ottomated/e507/README.md

- [Part choices & planning](./docs/Parts.md)

- Datasheets, symbols, footprints, 3d models, and spice models are in the respective folders in `./parts`

## Schematics

### Power
Power

### MCU
MCU

### Audio
Audio

### Root
Power

## PCB

PCB

### Rendered
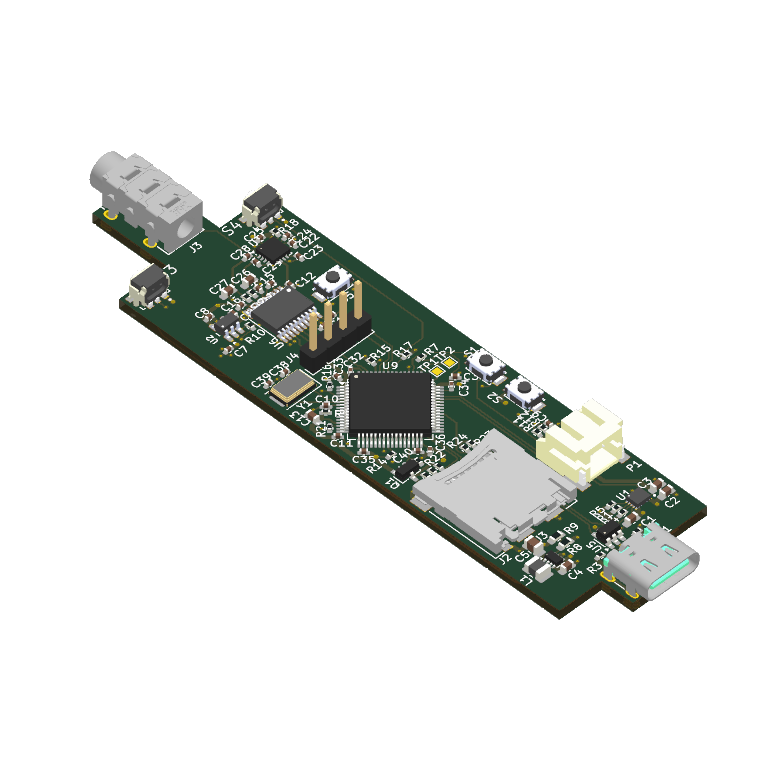
[picture p1: images/pcb.png]
Rendered
