ottomated/e507/docs/knob1.png

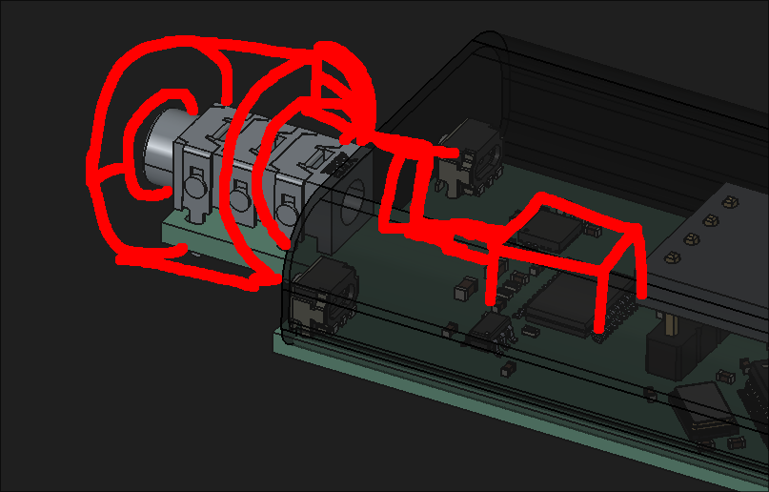
docs/knob1.png
