ottomated/e507/3d/case.FCStd

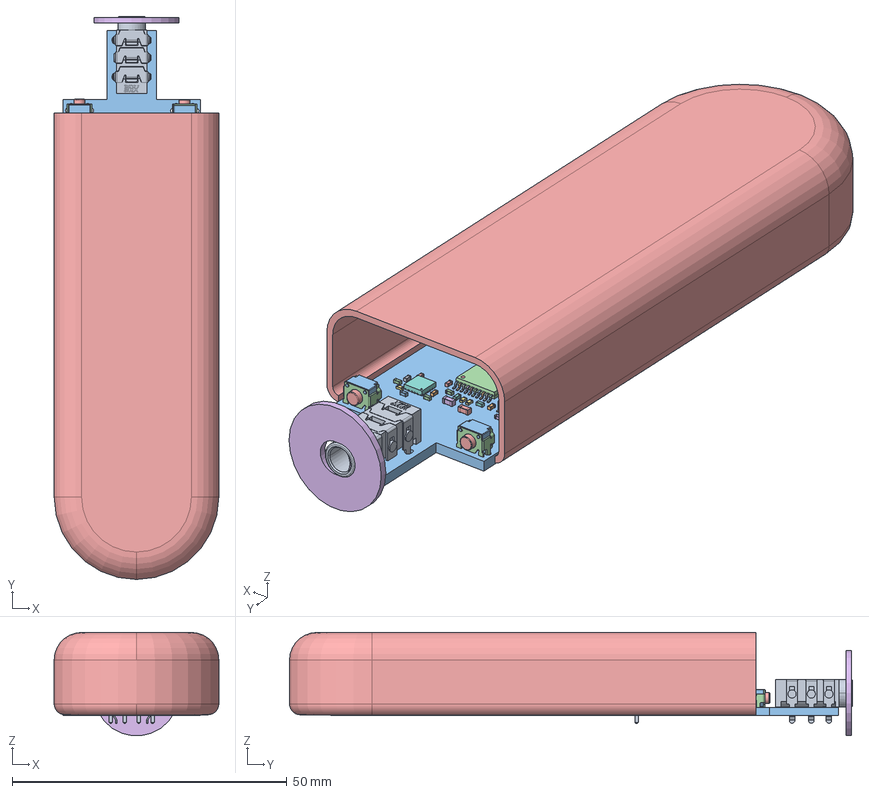
[picture p3: CAD file, 2026-11-06]
3d/case.FCStd
30.0 x 102.5 x 18.8 mm
R_0402_1005Metric
DM3CS-SF
C_0402_1005Metric
C_0402_1005Metric002
C_0402_1005Metric004
C_0603_1608Metric
S2B-PH-SM4-TB(LF)(SN)
S2B-PH-SM4-TB(LF)(SN)001
S2B-PH-SM4-TB(LF)(SN)002
S2B-PH-SM4-TB(LF)(SN)003
S2B-PH-SM4-TB(LF)(SN)004
TS-1088-AR02016
TS-1088-AR02017
TS-1088-AR02018
TS-1088-AR02019
C_0402_1005Metric006
PJ-3135-X
DBV5
DBV001
DBV002
DBV003
DBV004
DBV005
DBV006
C_0402_1005Metric008
L_1008_2520Metric
R_0402_1005Metric002
C_0402_1005Metric010
R_0402_1005Metric004
TS-1088-AR02022
TS-1088-AR02023
TS-1088-AR02024
TS-1088-AR02025
C_0603_1608Metric002
P021301_Shrinkwrap_1
P021301_Shrinkwrap_001
P021301_Shrinkwrap_002
C_0402_1005Metric012
R_0402_1005Metric006
C_0402_1005Metric014
R_0402_1005Metric008
LQFP-64_10x10mm_P0.5mm
TPS2116DRLR
TPS2116DRLR001
TPS2116DRLR002
TPS2116DRLR003
TPS2116DRLR004
TPS2116DRLR005
TPS2116DRLR006
TPS2116DRLR007
TPS2116DRLR008
TPS2116DRLR009
R_0402_1005Metric010
C_0402_1005Metric016
C_0402_1005Metric018
R_0402_1005Metric012
PinHeader_1x04_P254mm_Vertical
R_0402_1005Metric014
R_0402_1005Metric016
SOT-23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
