ottomated/e507/parts/amp/TPA6132A2RTER.step

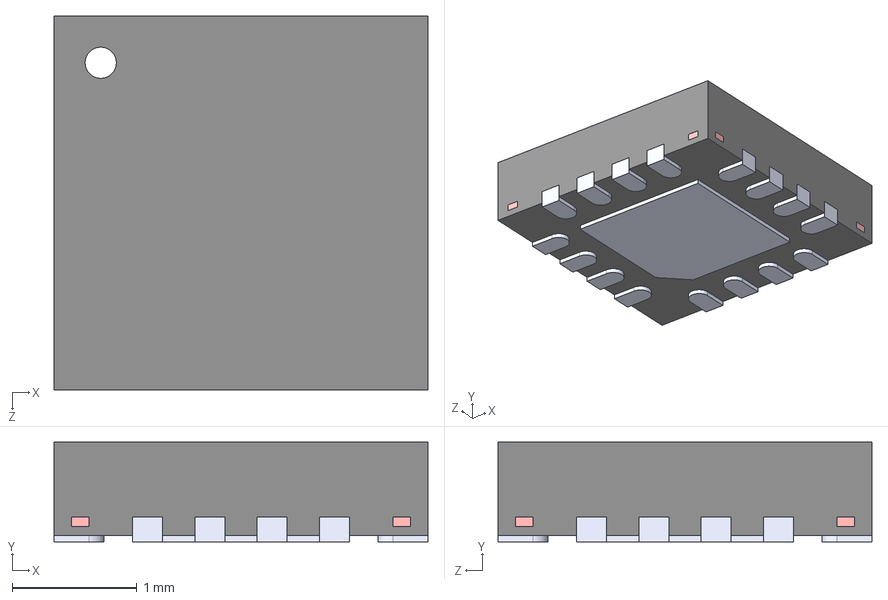
[picture p4: CAD file, 2026-10-21]
parts/amp/TPA6132A2RTER.step
3.00 x 0.8 x 3.00 mm
