ottomated/e507/parts/audio-jack/PJ-3135-B.stp

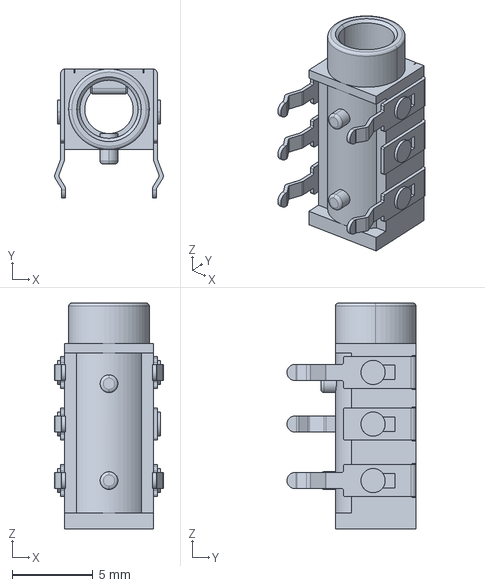
[picture p5: CAD file, 2026-11-05]
parts/audio-jack/PJ-3135-B.stp
6.74 x 8.00 x 14.0 mm
