ottomated/e507/(list of files, drawings)

Other design files:
parts/amp/spice/TPA6132A2.DSN
parts/amp/spice/TPA6132A2.OLB
parts/amp/spice/TPA6132A2.opj
parts/buck-boost/spice/GENERIC_BLOCKS.OLB
parts/buck-boost/spice/TPS631000.OLB
parts/buck-boost/spice/TPS631000_ENCRYPTED.DSN
parts/buck-boost/spice/TPS631000_Encrypted.opj
parts/buck-boost/spice/TPS631000_SYMBOL.OLB
parts/ldo/spice/TPS73601_TRANS.opj
