ottomated/e507/e507.kicad_pcb

## KiCad design e507.kicad_pcb (2026-11-12)

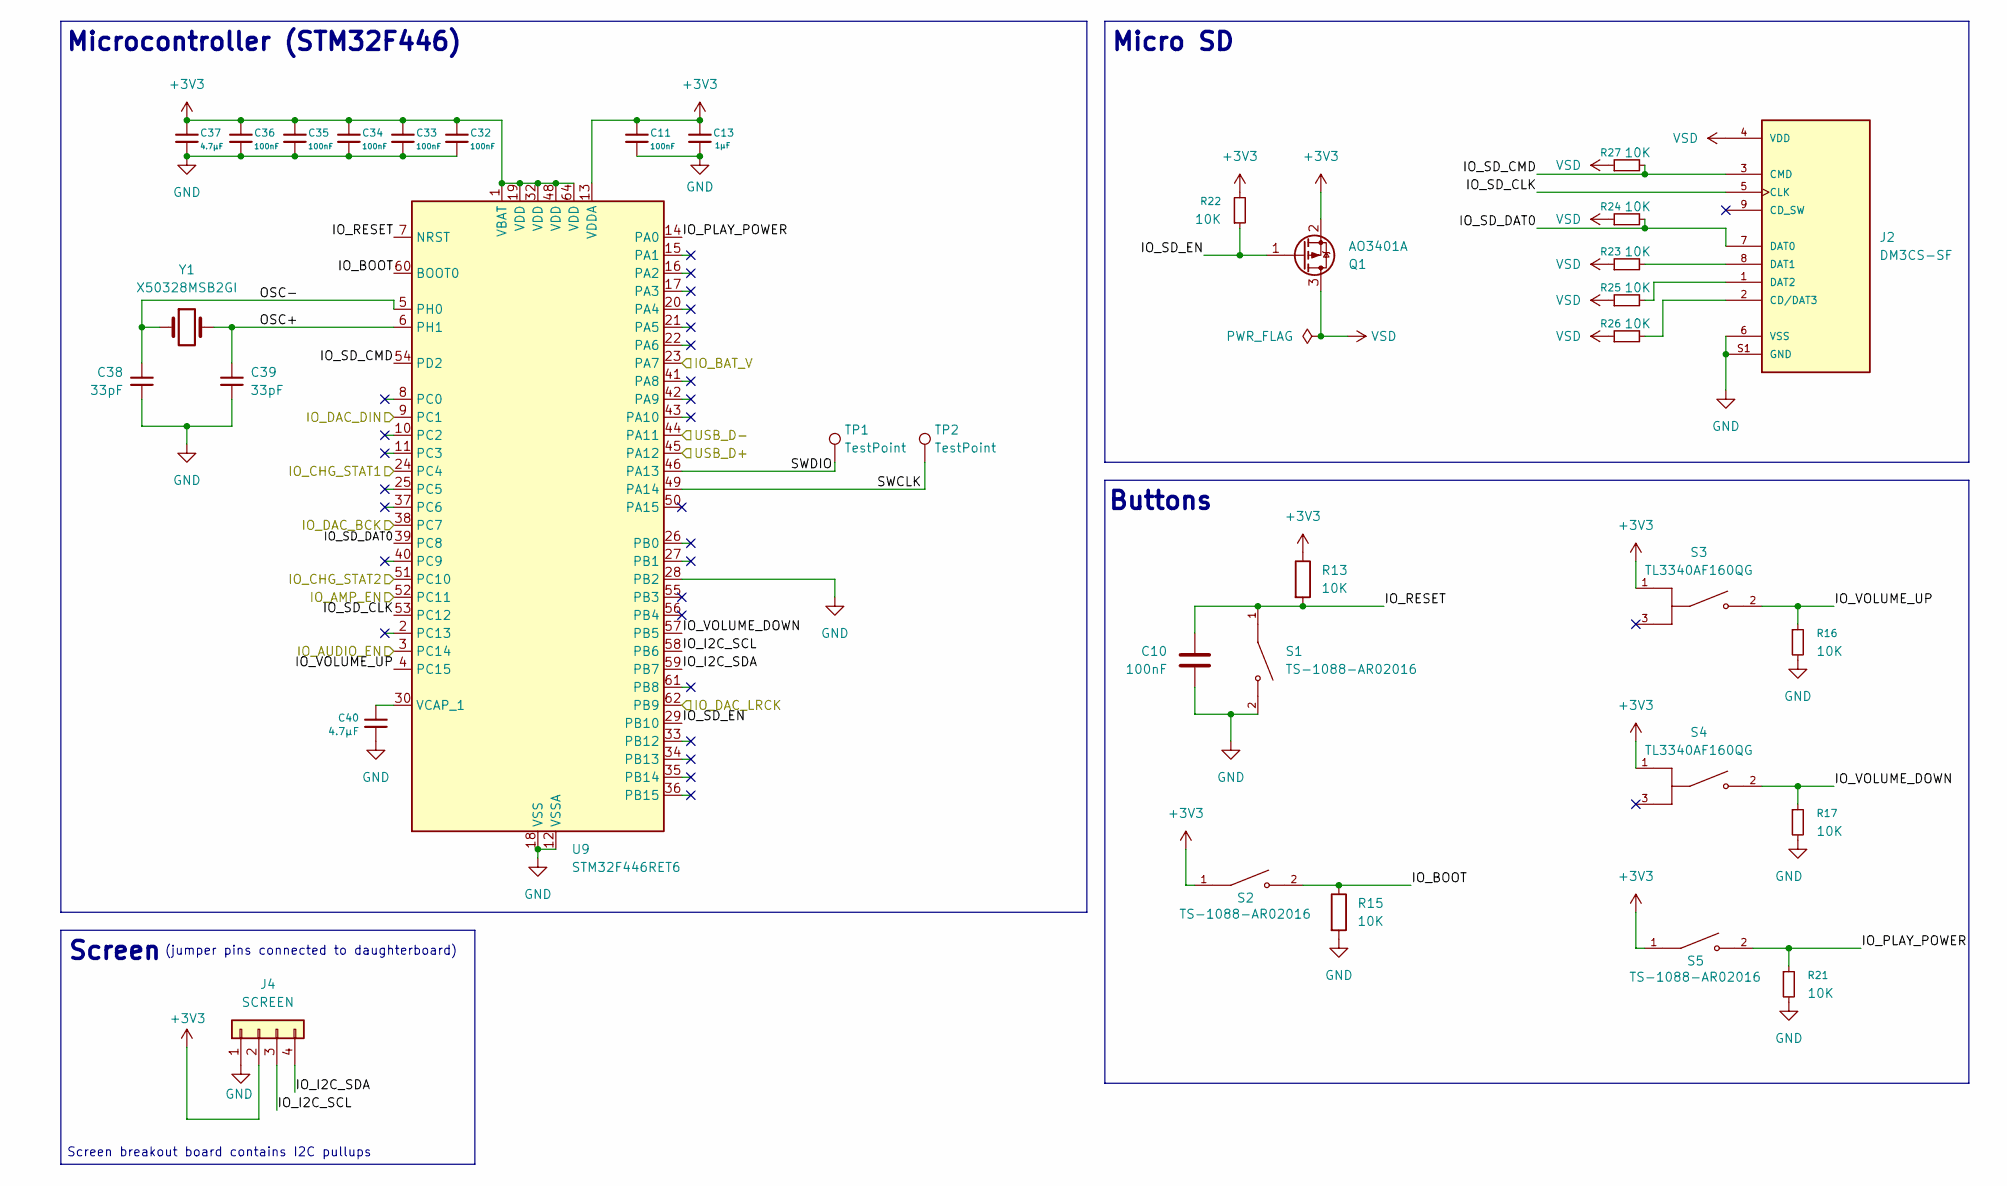
[picture p6: schematic mcu.kicad_sch]

Parts:
C10, C11, C32, C33, C34, C35, C36: 100nF; C_0402_1005Metric; Part # CL05B104KO5NNNC; LCSC Part # C1525
C13: 1µF; C_0603_1608Metric; Part # CL10A105KB8NNNC; LCSC Part # C15849
C37, C40: 4.7µF; C_0402_1005Metric; Part # CL05A475MP5NRNC; LCSC Part # C23733
C38, C39: 33pF; C_0402_1005Metric; Part # 0402CG330J500NT; LCSC Part # C1562
J2: DM3CS-SF; HRS_DM3CS-SF; PARTREV n/a; LCSC Part # C202111
J4: SCREEN; PinHeader_1x04_P2.54mm_Vertical; Part # 2.54-1*4; LCSC Part # C5116483
Q1: AO3401A; SOT-23; Part # AO3401A; LCSC Part # C15127
R13, R15, R16, R17, R21, R22, R23, R24, R25, R26, R27: 10K; R_0402_1005Metric; Part # 0402WGF1002TCE; LCSC Part # C25744
S1, S2, S5: TS-1088-AR02016; SW_TS-1088-AR02016; PARTREV N/A; LCSC Part # C720477
S3, S4: TL3340AF160QG; SW_TL3340AF160QG; Part # TL3340AF160QG; LCSC Part # C2886925
TP1, TP2: TestPoint; TestPoint_Pad_1.0x1.0mm
U9: STM32F446RET6; LQFP-64_10x10mm_P0.5mm; Part # STM32F446RET6; LCSC Part # C69336
Y1: X50328MSB2GI; Crystal_SMD_5032-2Pin_5.0x3.2mm; Part # X50328MSB2GI; LCSC Part # C115962

Connections:
+3V3: C11.1, C13.2, C32.1, C33.1, C34.1, C35.1, C36.1, C37.1, J4.2, Q1.2 (S), R13.1, R22.2, S2.1, S3.1, S4.1, S5.1, U9.1 (VBAT), U9.13 (VDDA), U9.19 (VDD), U9.32 (VDD), U9.48 (VDD), U9.64 (VDD); also elsewhere on the board
/Audio/IO_AMP_EN: U9.52 (PC11); also elsewhere on the board
/Audio/IO_DAC_BCK: U9.38 (PC7); also elsewhere on the board
/Audio/IO_DAC_DIN: U9.9 (PC1); also elsewhere on the board
/Audio/IO_DAC_LRCK: U9.62 (PB9); also elsewhere on the board
/MCU/IO_AUDIO_EN: U9.3 (PC14); also elsewhere on the board
/MCU/IO_BAT_V: U9.23 (PA7); also elsewhere on the board
/MCU/IO_BOOT: R15.1, S2.2, U9.60 (BOOT0)
/MCU/IO_CHG_STAT1: U9.24 (PC4); also elsewhere on the board
/MCU/IO_CHG_STAT2: U9.51 (PC10); also elsewhere on the board
/MCU/IO_I2C_SCL: J4.3, U9.58 (PB6)
/MCU/IO_I2C_SDA: J4.4, U9.59 (PB7)
/MCU/IO_PLAY_POWER: R21.1, S5.2, U9.14 (PA0)
/MCU/IO_RESET: C10.1, R13.2, S1.1, U9.7 (NRST)
/MCU/IO_SD_CLK: J2.5 (CLK), U9.53 (PC12)
/MCU/IO_SD_CMD: J2.3 (CMD), R27.2, U9.54 (PD2)
/MCU/IO_SD_DAT0: J2.7 (DAT0), R24.2, U9.39 (PC8)
/MCU/IO_SD_EN: Q1.1 (G), R22.1, U9.29 (PB10)
/MCU/IO_VOLUME_DOWN: R17.1, S4.2, U9.57 (PB5)
/MCU/IO_VOLUME_UP: R16.1, S3.2, U9.4 (PC15)
/MCU/OSC+: C39.1, U9.6 (PH1), Y1.2
/MCU/OSC-: C38.1, U9.5 (PH0), Y1.1
/MCU/SWCLK: TP2.1 (1_1), U9.49 (PA14)
/MCU/SWDIO: TP1.1 (1_1), U9.46 (PA13)
/MCU/USB_D+: U9.45 (PA12); also elsewhere on the board
/MCU/USB_D-: U9.44 (PA11); also elsewhere on the board
GND: C10.2, C11.2, C13.1, C32.2, C33.2, C34.2, C35.2, C36.2, C37.2, C38.2, C39.2, C40.2, J2.6 (VSS), J2.S1 (GND), J2.S2 (GND), J2.S3 (GND), J2.S5 (GND), J4.1, R15.2, R16.2, R17.2, R21.2, S1.2, U9.12 (VSSA), U9.18 (VSS), U9.28 (PB2), U9.31 (VSS), U9.47 (VSS), U9.63 (VSS); also elsewhere on the board
unnamed: J2.2 (CD/DAT3), R26.2
unnamed: J2.8 (DAT1), R23.2
unnamed: J2.1 (DAT2), R25.2
unnamed: C40.1, U9.30 (VCAP_1)
VSD: J2.4 (VDD), Q1.3 (D), R23.1, R24.1, R25.1, R26.1, R27.1

Notes on the sheet:
(jumper pins connected to daughterboard)
Micro SD
Buttons
Screen breakout board contains I2C pullups
Microcontroller (STM32F446)
Screen

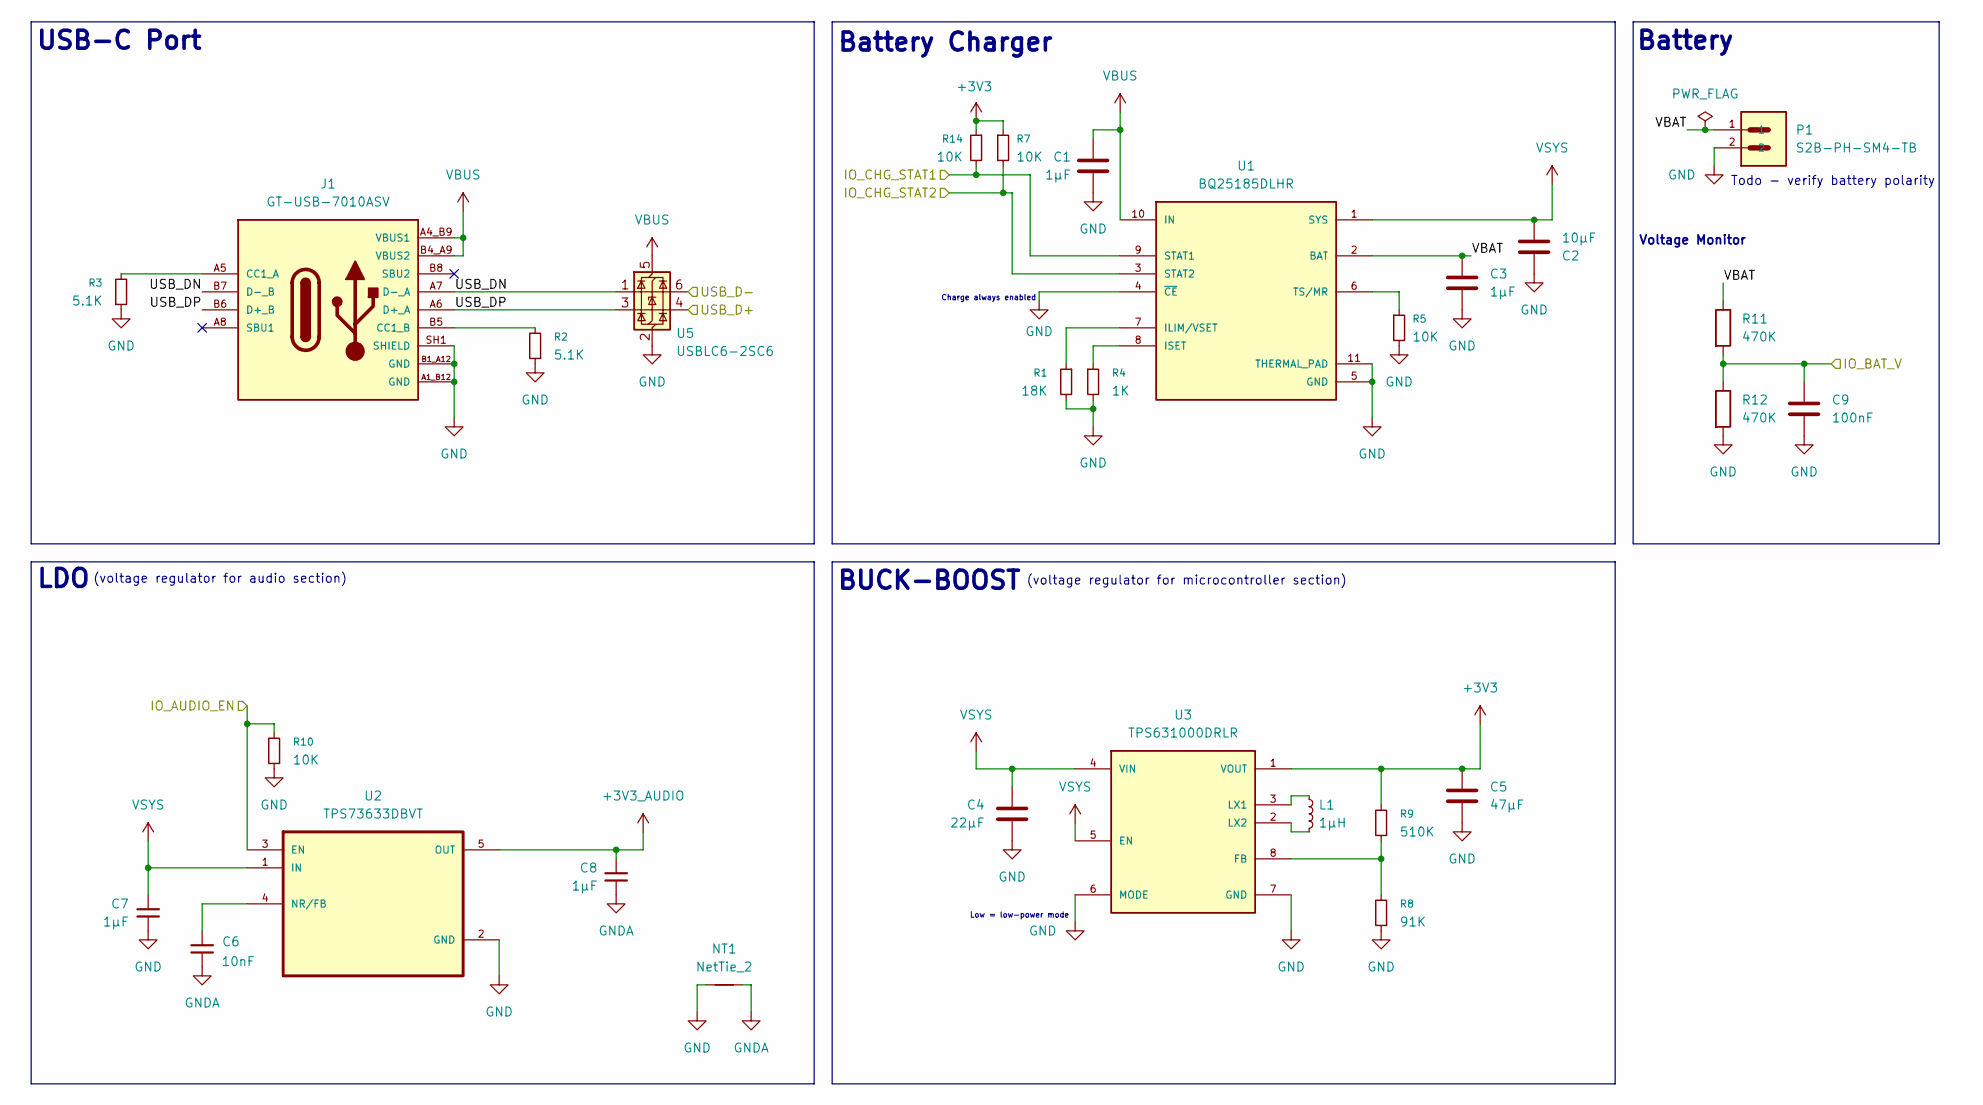
[picture p7: schematic power.kicad_sch]

Parts:
C1, C3: 1µF; C_0603_1608Metric; Part # CL10A105KB8NNNC; LCSC Part # C15849
C2: 10µF; C_0603_1608Metric; Part # CL10A106MA8NRNC; LCSC Part # C96446
C4: 22µF; C_0603_1608Metric; Part # CL10A226MQ8NRNC; LCSC Part # C59461
C5: 47µF; C_0805_2012Metric; Part # CL21A476MQYNNNE; LCSC Part # C16780
C6: 10nF; C_0402_1005Metric; Part # CL05B103KB5NNNC; LCSC Part # C15195
C7, C8: 1µF; C_0402_1005Metric; Part # CL05A105KA5NQNC; LCSC Part # C52923
C9: 100nF; C_0402_1005Metric; Part # CL05B104KO5NNNC; LCSC Part # C1525
J1: GT-USB-7010ASV; AMPHENOL_12402012E212A; PARTREV 4; LCSC Part # C2988369
L1: 1μH; L_1008_2520Metric; Part # DFE252012P-1R0M=P2; LCSC Part # C882955
NT1: NetTie_2; NetTie-2_SMD_Pad0.5mm
P1: S2B-PH-SM4-TB; JST_S2B-PH-SM4-TB; Part # XY-S2B-PH-SM4-TB; LCSC Part # C54582899
R1: 18K; R_0402_1005Metric; Part # 0402WGF1802TCE; LCSC Part # C25762
R2, R3: 5.1K; R_0402_1005Metric; Part # 0402WGF5101TCE; LCSC Part # C25905
R4: 1K; R_0402_1005Metric; Part # 0402WGF1001TCE; LCSC Part # C11702
R5, R7, R10, R14: 10K; R_0402_1005Metric; Part # 0402WGF1002TCE; LCSC Part # C25744
R8: 91K; R_0603_1608Metric; Part # 0603WAF9102T5E; LCSC Part # C23265
R9: 510K; R_0603_1608Metric; Part # 0603WAF5103T5E; LCSC Part # C23192
R11: 470K; R_0402_1005Metric; LCSC Part # C25790
R12: 470K; R_0402_1005Metric; Part # 0603WAF4703T5E; LCSC Part # C25790
U1: BQ25185DLHR; IC_BQ25185DLHR; PARTREV OCTOBER 2023; LCSC Part # C19725033
U2: TPS73633DBVT; SOT95P280X145-5N; Part # TPS73633DBVT; LCSC Part # C2864221
U3: TPS631000DRLR; SOT-583-8; PARTREV B; LCSC Part # C5219190
U5: USBLC6-2SC6; SOT-23-6; Part # ST USBLC6-2SC6; LCSC Part # C7519

Connections:
+3V3: C5.2, R7.1, R9.2, R14.1, U3.1 (VOUT); also elsewhere on the board
+3V3_AUDIO: C8.1, U2.5 (OUT); also elsewhere on the board
/MCU/IO_AUDIO_EN: R10.2, U2.3 (EN); also elsewhere on the board
/MCU/IO_BAT_V: C9.1, R11.2, R12.1; also elsewhere on the board
/MCU/IO_CHG_STAT1: R14.2, U1.9 (STAT1); also elsewhere on the board
/MCU/IO_CHG_STAT2: R7.2, U1.3 (STAT2); also elsewhere on the board
/MCU/USB_D+: U5.4 (I/O2); also elsewhere on the board
/MCU/USB_D-: U5.6 (I/O1); also elsewhere on the board
/Power/USB_DN: J1.A7 (D-_A), J1.B7 (D-_B), U5.1 (I/O1)
/Power/USB_DP: J1.A6 (D+_A), J1.B6 (D+_B), U5.3 (I/O2)
/Power/VBAT: C3.2, P1.1, R11.1, U1.2 (BAT)
GND: C1.1, C2.2, C3.1, C4.1, C5.1, C7.1, C9.2, J1.A1_B12 (GND), J1.B1_A12 (GND), J1.SH1 (SHIELD), J1.SH2 (SHIELD), J1.SH3 (SHIELD), J1.SH4 (SHIELD), NT1.1, P1.2, R1.2, R2.1, R3.1, R4.2, R5.2, R8.1, R10.1, R12.2, U1.4 (~CE), U1.5 (GND), U1.11 (THERMAL_PAD), U1.12, U1.13, U2.2 (GND), U3.6 (MODE), U3.7 (GND), U5.2 (GND); also elsewhere on the board
GNDA: C6.1, C8.2, NT1.2; also elsewhere on the board
unnamed: J1.A5 (CC1_A), R3.2
unnamed: J1.B5 (CC1_B), R2.2
unnamed: R1.1, U1.7 (ILIM/VSET)
unnamed: R4.1, U1.8 (ISET)
unnamed: R5.1, U1.6 (TS/MR)
unnamed: C6.2, U2.4 (NR/FB)
unnamed: R8.2, R9.1, U3.8 (FB)
unnamed: L1.1, U3.3 (LX1)
unnamed: L1.2, U3.2 (LX2)
VBUS: C1.2, J1.A4_B9 (VBUS1), J1.B4_A9 (VBUS), U1.10 (IN), U5.5 (VBUS)
VSYS: C2.1, C4.2, C7.2, U1.1 (SYS), U2.1 (IN), U3.4 (VIN), U3.5 (EN)

Notes on the sheet:
Charge always enabled
Battery Charger
(voltage regulator for microcontroller section)
Low = low-power mode
USB-C Port
Todo - verify battery polarity
(voltage regulator for audio section)
Battery
Voltage Monitor
LDO
BUCK-BOOST

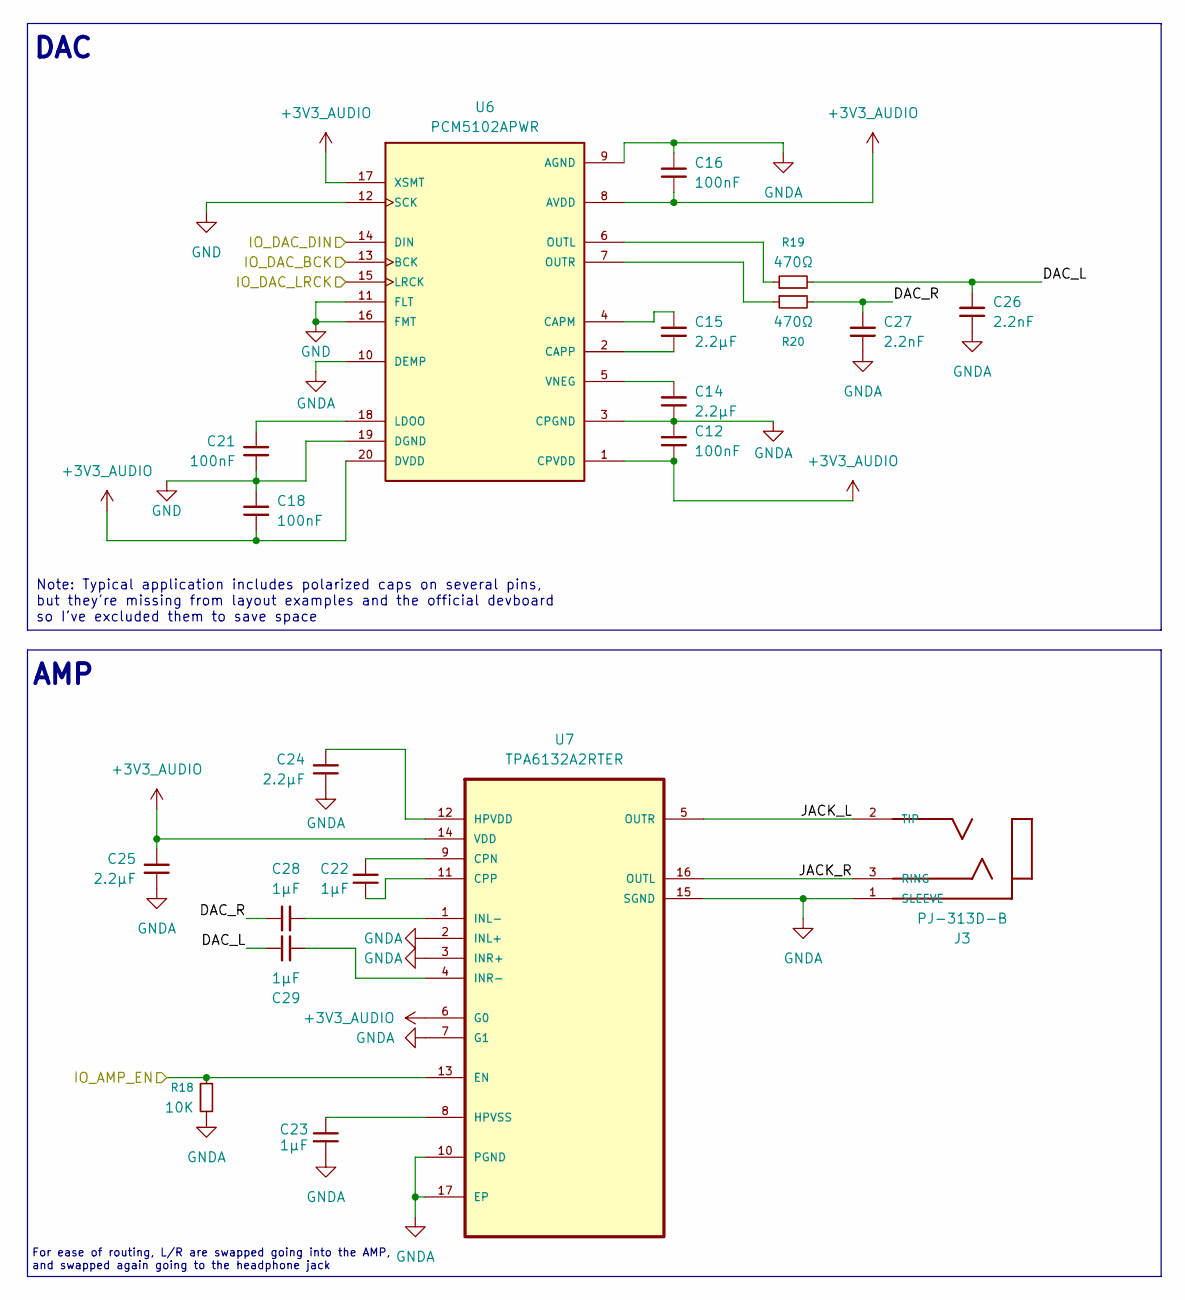
[picture p8: schematic audio.kicad_sch]

Parts:
C12, C16, C18, C21: 100nF; C_0402_1005Metric; Part # CL05B104KB54PNC; LCSC Part # C307331
C14, C15, C24, C25: 2.2µF; C_0402_1005Metric; Part # CL05A225MQ5NSNC; LCSC Part # C12530
C22, C23, C28, C29: 1µF; C_0402_1005Metric; Part # CL05A105KA5NQNC; LCSC Part # C52923
C26, C27: 2.2nF; C_0603_1608Metric; Part # 0603B222K500NT; LCSC Part # C1604
J3: PJ-313D-B; PJ-3135-B; Part # PJ-313D-B; LCSC Part # C319112
R18: 10K; R_0402_1005Metric; Part # 0402WGF1002TCE; LCSC Part # C25744
R19, R20: 470Ω; R_0402_1005Metric; Part # 0402WGF4700TCE; LCSC Part # C25117
U6: PCM5102APWR; SOP65P640X120-20N; PARTREV C; LCSC Part # C107671
U7: TPA6132A2RTER; WQFN-16-1EP_3x3mm_P0.5mm_EP1.6x1.6mm_ThermalVias; MPN TPA6132A2RTER; LCSC Part # C69901

Connections:
+3V3_AUDIO: C12.2, C16.2, C18.2, C25.1, U6.1 (CPVDD), U6.8 (AVDD), U6.17 (XSMT), U6.20 (DVDD), U7.6 (G0), U7.14 (VDD); also elsewhere on the board
/Audio/DAC_L: C26.1, C29.1, R19.2
/Audio/DAC_R: C27.1, C28.1, R20.2
/Audio/IO_AMP_EN: R18.1, U7.13 (EN); also elsewhere on the board
/Audio/IO_DAC_BCK: U6.13 (BCK); also elsewhere on the board
/Audio/IO_DAC_DIN: U6.14 (DIN); also elsewhere on the board
/Audio/IO_DAC_LRCK: U6.15 (LRCK); also elsewhere on the board
/Audio/JACK_L: J3.2 (TIP), U7.5 (OUTR)
/Audio/JACK_R: J3.3 (RING), U7.16 (OUTL)
GND: C18.1, C21.2, U6.11 (FLT), U6.12 (SCK), U6.16 (FMT), U6.19 (DGND); also elsewhere on the board
GNDA: C12.1, C14.2, C16.1, C23.1, C24.2, C25.2, C26.2, C27.2, J3.1 (SLEEVE), R18.2, U6.3 (CPGND), U6.9 (AGND), U6.10 (DEMP), U7.2 (INL+), U7.3 (INR+), U7.7 (G1), U7.10 (PGND), U7.15 (SGND), U7.17 (EP); also elsewhere on the board
unnamed: C15.1, U6.4 (CAPM)
unnamed: C15.2, U6.2 (CAPP)
unnamed: C21.1, U6.18 (LDOO)
unnamed: R19.1, U6.6 (OUTL)
unnamed: R20.1, U6.7 (OUTR)
unnamed: C14.1, U6.5 (VNEG)
unnamed: C22.1, U7.9 (CPN)
unnamed: C22.2, U7.11 (CPP)
unnamed: C24.1, U7.12 (HPVDD)
unnamed: C23.2, U7.8 (HPVSS)
unnamed: C28.2, U7.1 (INL-)
unnamed: C29.2, U7.4 (INR-)

Notes on the sheet:
Note: Typical application includes polarized caps on several pins, but they're missing from layout examples and the official devboard so I've excluded them to save space
DAC
For ease of routing, L/R are swapped going into the AMP, and swapped again going to the headphone jack
AMP

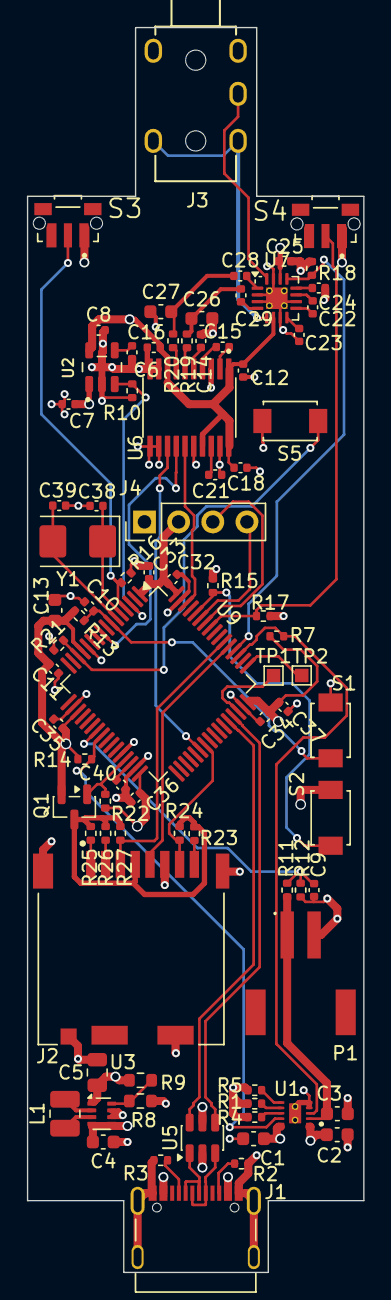
[picture p9: board e507.kicad_pcb from above]

Board: 4 copper layers, 25.0 x 92.5 mm, 84 parts (0 on the bottom side), 64 nets.
