ottomated/e507/(commit log)

2026-10-13 power stuff
2026-10-22 start power schematic
2026-10-23 finish power schematic
2026-10-25 work on pcb
2026-10-27 Finish? schematic
2026-10-30 switch to stm32, wire audio section
2026-10-31 add mpns to buck boost
2026-10-31 Finish all power MPNs
2026-11-05 sd card circuitry
2026-11-05 set mosfet part number
2026-11-05 replace headphone jack, start cad
2026-11-06 case work
2026-11-06 thicker inductor traces
2026-11-07 point power up, gnd down
2026-11-08 sync pcb
2026-11-08 switch more capacitors
2026-11-08 add kicad 3d models
2026-11-08 switch to raw kicad-cli
2026-11-08 use kicad docker
2026-11-11 wire last gpios
2026-11-11 fix resistor value
2026-11-11 move play power to PA0
2026-11-11 button model
2026-11-12 fix gnd pads
